stojnev/dwr-vta/VTA Mechanism [HIGH]/PDF/SME_cutout_VTA_HIGH [ISO] [PDF].pdf

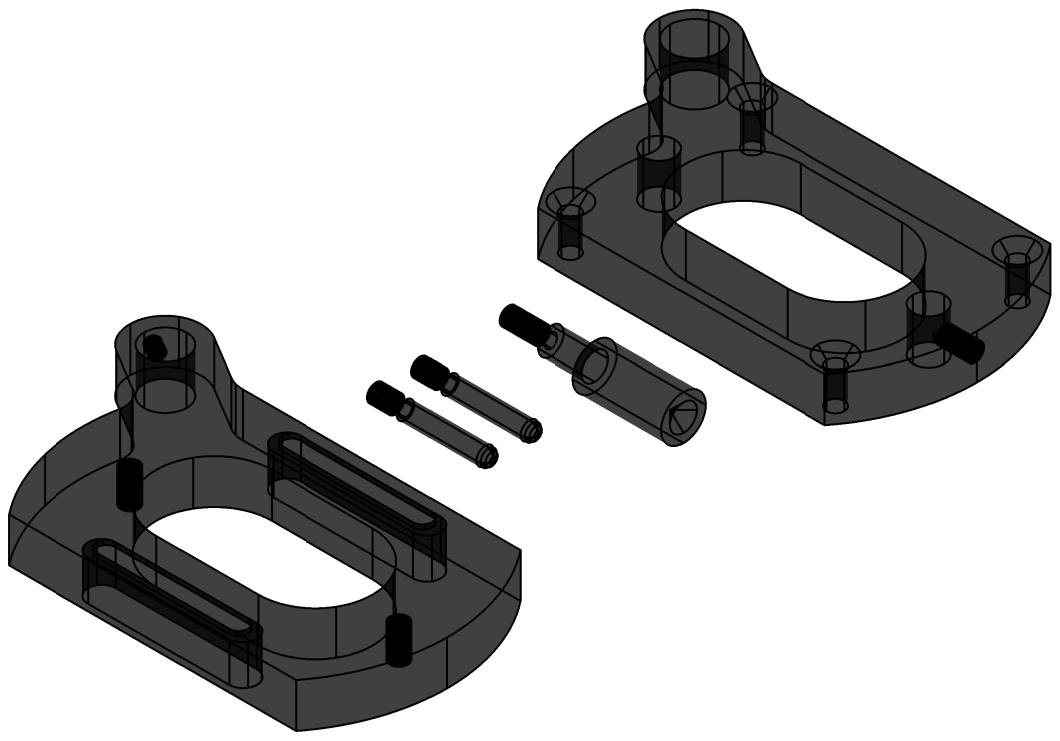
[picture p2: page 1]
