stojnev/dwr-vta/VTA Mechanism [HIGH]/PDF/SME_cutout_VTA_HIGH [TOP] [PDF].pdf

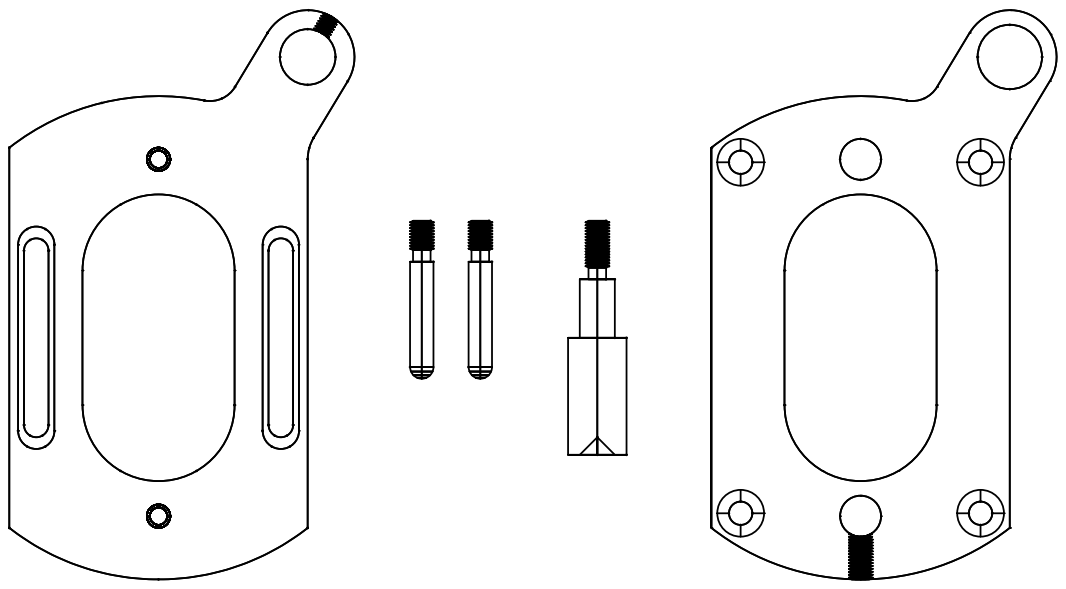
[picture p3: page 1]
