stojnev/dwr-vta/VTA Mechanism [LOW]/PDF/SME_cutout_VTA_LOW [ISO] [PDF].pdf

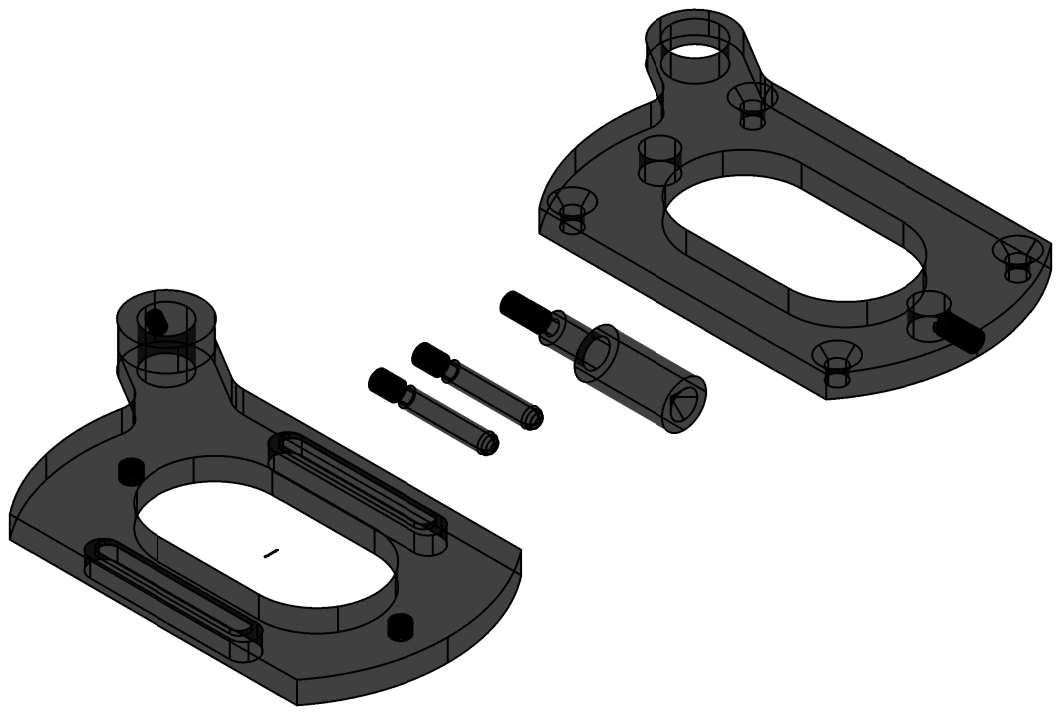
[picture p4: page 1]
