stojnev/dwr-vta/VTA Mechanism [LOW]/PDF/SME_cutout_VTA_LOW [TOP] [PDF].pdf

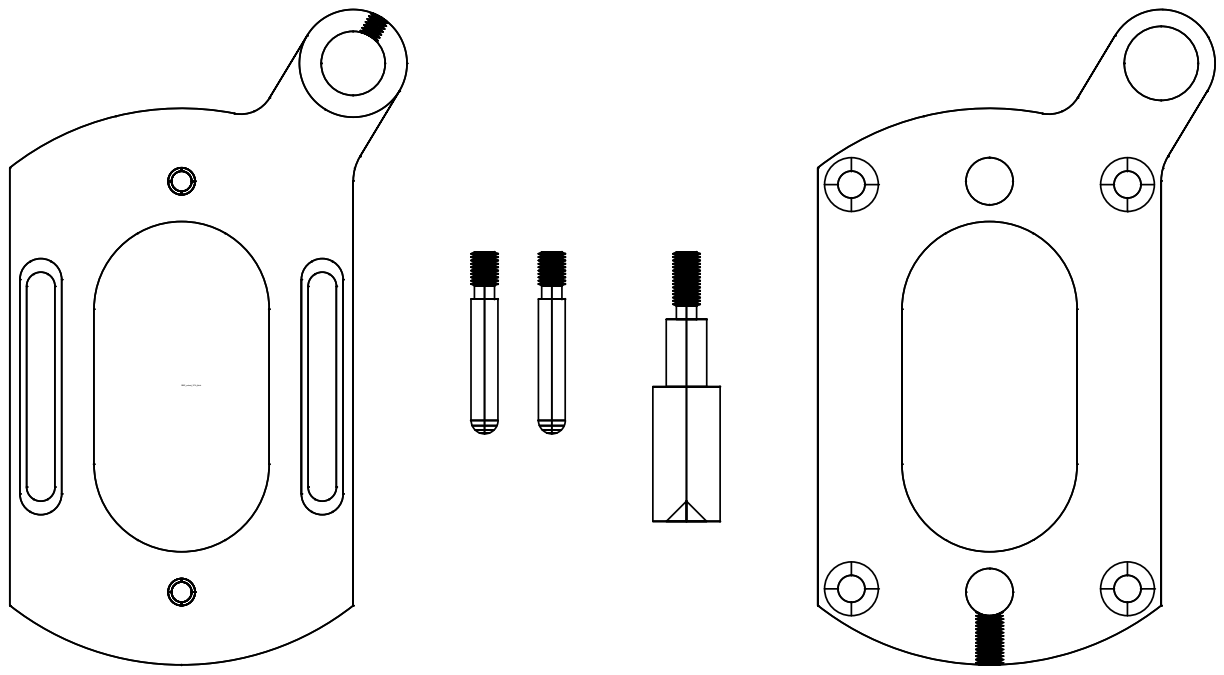
[picture p5: page 1]
