stojnev/dwr-vta/VTA Mechanism [LOW]/DXF/SME_cutout_VTA_LOW [DXF].dxf

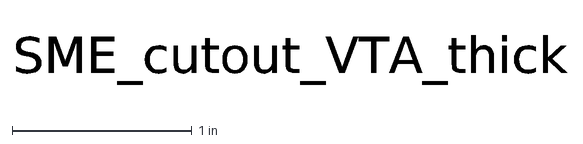
[picture p1: CAD file, 2021-07-08]
VTA Mechanism [LOW]/DXF/SME_cutout_VTA_LOW [DXF].dxf
SME_cutout_VTA_thick
