stojnev/dwr-vta/(list of files, cad)

Other CAD files:
VTA Mechanism [HIGH]/DXF/SME_cutout_VTA_HIGH [DXF].dxf
